MattKai45/Tach-to-CAN/Tach-to-CAN.brd

## EAGLE design Tach-to-CAN.brd (2020-04-09)

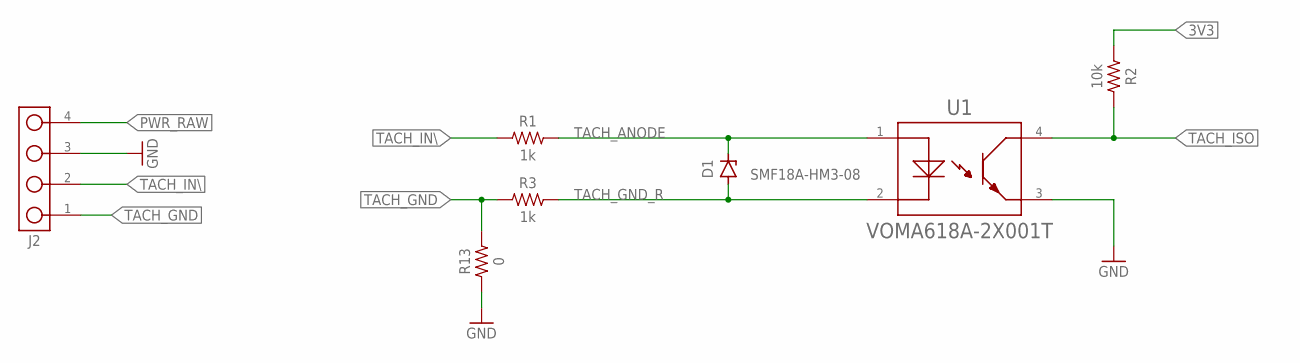
[picture p1: schematic Tach-to-CAN.sch, sheet 1, TACHOMETER ISOLATION]

Parts:
D1: VISHAY_SMF18A-HM3-08; VISHAY_SMFXXA-HM3-08
J2: CONN_4PIN_VERT; CONN_100MIL_4_PIN
R1, R3: 1k; REST-0603
R2: 10k; REST-0603
R13: 0; REST-0603
U1: VISHAY_VOMA618A-2X001T; VISHAY_SOP-4

Connections:
3V3: R2.1; also elsewhere on the board
GND: J2.3, R13.1, U1.3; also elsewhere on the board
PWR_RAW: J2.4; also elsewhere on the board
TACH_ANODE: D1.C, R1.2, U1.1
TACH_GND: J2.1, R3.1, R13.2
TACH_GND_R: D1.A, R3.2, U1.2
TACH_IN\: J2.2, R1.1
TACH_ISO: R2.2, U1.4; also elsewhere on the board

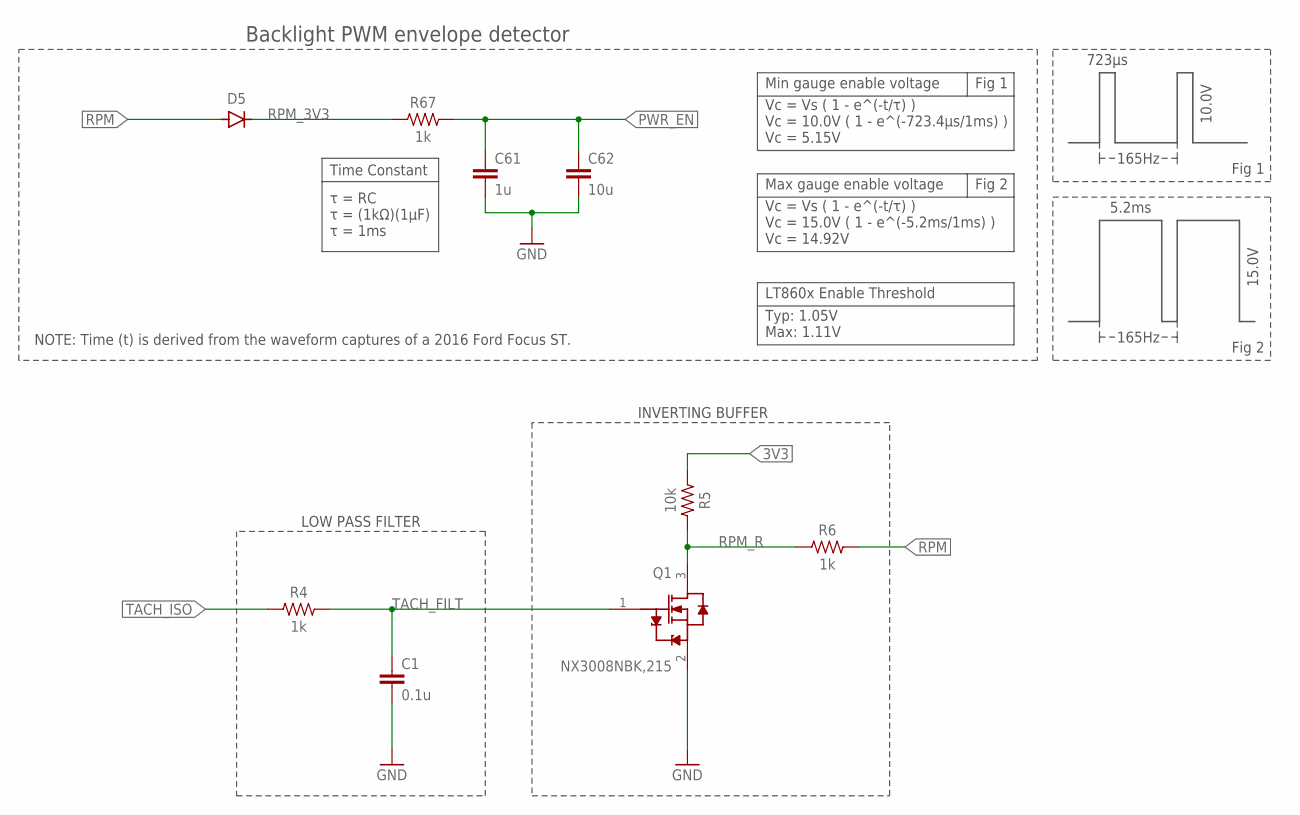
[picture p2: schematic Tach-to-CAN.sch, sheet 2, SIGNAL CONDITIONING]

Parts:
C1: 0.1u; CAP-0603
C61: 1u; CAP-0805
C62: 10u; CAP-1206
D5: AVX_SD1206S040S2R0
Q1: NXP_NX3008NBK,215NXP_SOT23; NXP_SOT23
R4, R6, R67: 1k; REST-0603
R5: 10k; REST-0603

Connections:
3V3: R5.1; also elsewhere on the board
GND: C1.2, C61.2, C62.2, Q1.2 (S); also elsewhere on the board
PWR_EN: C61.1, C62.1, R67.2; also elsewhere on the board
RPM: D5.A, R6.2; also elsewhere on the board
RPM_3V3: D5.C, R67.1
RPM_R: Q1.3 (D), R5.2, R6.1
TACH_FILT: C1.1, Q1.1 (G), R4.2
TACH_ISO: R4.1; also elsewhere on the board

Notes on the sheet:
LOW PASS FILTER
INVERTING BUFFER
Backlight PWM envelope detector
τ = RC τ = (1kΩ)(1µF) τ = 1ms
Vc = Vs ( 1 - e^(-t/τ) ) Vc = 10.0V ( 1 - e^(-723.4µs/1ms) ) Vc = 5.15V
Vc = Vs ( 1 - e^(-t/τ) ) Vc = 15.0V ( 1 - e^(-5.2ms/1ms) ) Vc = 14.92V
Max gauge enable voltage
Min gauge enable voltage
Time Constant
Typ: 1.05V Max: 1.11V
LT860x Enable Threshold
NOTE: Time (t) is derived from the waveform captures of a 2016 Ford Focus ST.
723µs
5.2ms
15.0V
10.0V
165Hz
Fig 1
Fig 2

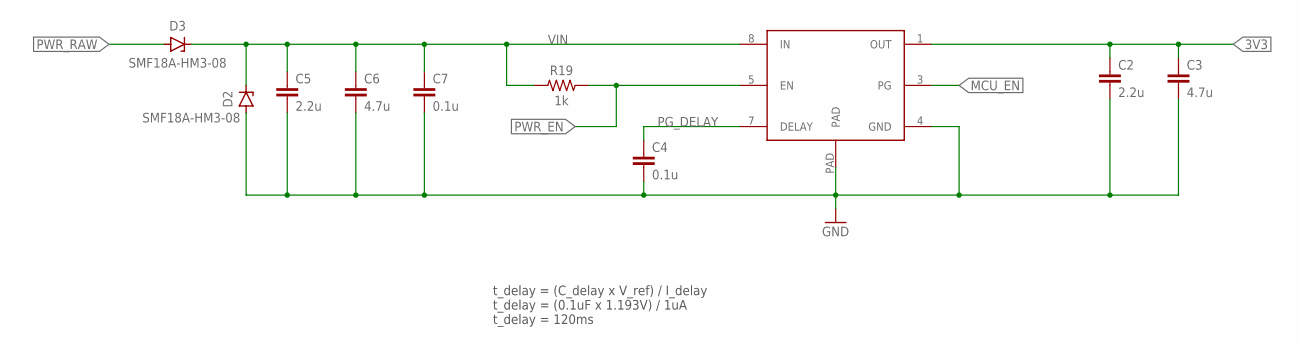
[picture p3: schematic Tach-to-CAN.sch, sheet 3, POWER]

Parts:
C2, C5: 2.2u; CAP-0805
C3, C6: 4.7u; CAP-1206
C4, C7: 0.1u; CAP-0603
D2, D3: VISHAY_SMF18A-HM3-08; VISHAY_SMFXXA-HM3-08
R19: 1k; REST-0603
U3: TI_TPS7A1633AQDGNRQ1; TI_MSSOP8

Connections:
3V3: C2.1, C3.1, U3.1 (OUT); also elsewhere on the board
GND: C2.2, C3.2, C4.2, C5.2, C6.2, C7.2, D2.A, U3.4 (GND), U3.PAD; also elsewhere on the board
MCU_EN: U3.3 (PG); also elsewhere on the board
PG_DELAY: C4.1, U3.7 (DELAY)
PWR_EN: R19.2, U3.5 (EN); also elsewhere on the board
PWR_RAW: D3.A; also elsewhere on the board
VIN: C5.1, C6.1, C7.1, D2.C, D3.C, R19.1, U3.8 (IN)

Notes on the sheet:
t_delay = (C_delay x V_ref) / I_delay t_delay = (0.1uF x 1.193V) / 1uA t_delay = 120ms

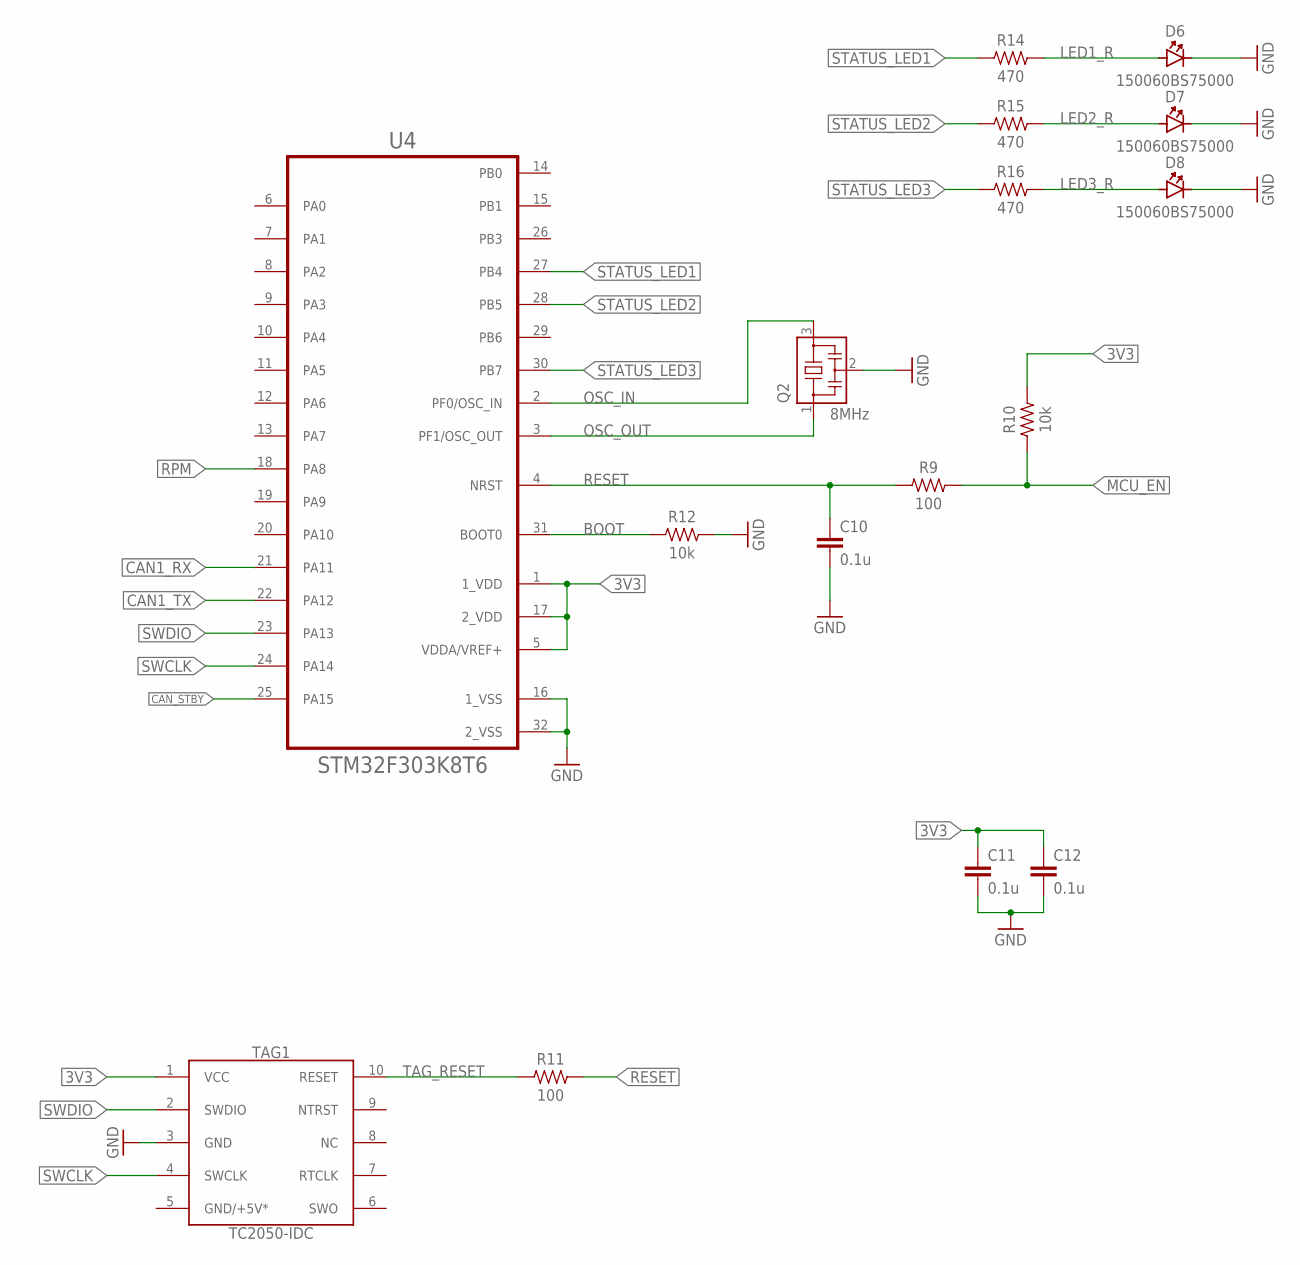
[picture p4: schematic Tach-to-CAN.sch, sheet 4, MICROCONTROLLER]

Parts:
C10, C11, C12: 0.1u; CAP-0603
D6, D7, D8: LED_BLUE_0603_WURTH; WURTH_0603_LED
Q2: 8MHz; CSTCR6M
R9, R11: 100; REST-0603
R10, R12: 10k; REST-0603
R14, R15, R16: 470; REST-0603
TAG1: TC2050-IDC
U4: STM32F303K8T6STMICROELECTRONICS_STM32F303K8T6; STM32F303K8T6

Connections:
3V3: C11.1, C12.1, R10.2, TAG1.1 (VCC), U4.1 (1_VDD), U4.5 (VDDA/VREF+), U4.17 (2_VDD); also elsewhere on the board
BOOT: R12.1, U4.31 (BOOT0)
CAN1_RX: U4.21 (PA11); also elsewhere on the board
CAN1_TX: U4.22 (PA12); also elsewhere on the board
CAN_STBY: U4.25 (PA15); also elsewhere on the board
GND: C10.2, C11.2, C12.2, D6.C, D7.C, D8.C, Q2.2, R12.2, TAG1.3 (GND), U4.16 (1_VSS), U4.32 (2_VSS); also elsewhere on the board
LED1_R: D6.A, R14.2
LED2_R: D7.A, R15.2
LED3_R: D8.A, R16.2
MCU_EN: R9.2, R10.1; also elsewhere on the board
OSC_IN: Q2.3, U4.2 (PF0/OSC_IN)
OSC_OUT: Q2.1, U4.3 (PF1/OSC_OUT)
RESET: C10.1, R9.1, R11.2, U4.4 (NRST)
RPM: U4.18 (PA8); also elsewhere on the board
STATUS_LED1: R14.1, U4.27 (PB4)
STATUS_LED2: R15.1, U4.28 (PB5)
STATUS_LED3: R16.1, U4.30 (PB7)
SWCLK: TAG1.4 (SWCLK), U4.24 (PA14)
SWDIO: TAG1.2 (SWDIO), U4.23 (PA13)
TAG_RESET: R11.1, TAG1.10 (RESET)

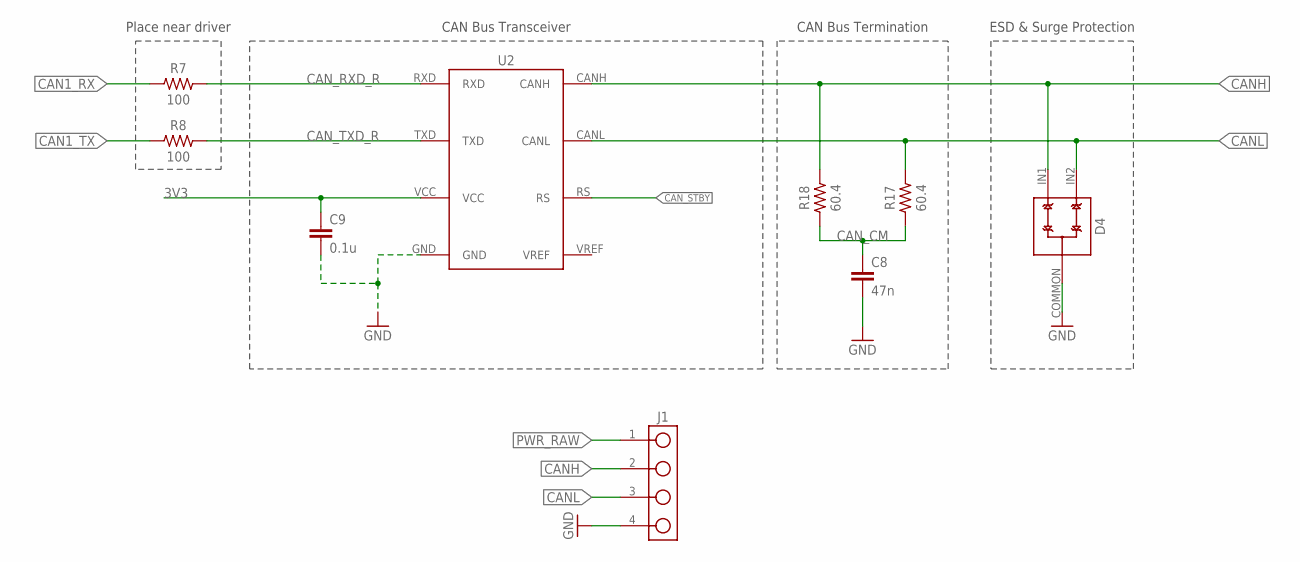
[picture p5: schematic Tach-to-CAN.sch, sheet 5, CAN BUS]

Parts:
C8: 47n; CAP-0603
C9: 0.1u; CAP-0603
D4: CDSOT23-T24CAN-Q; BOURNS_CDSOT23-T24CAN-Q
J1: CONN_4PIN_VERT; CONN_100MIL_4_PIN
R7, R8: 100; REST-0603
R17, R18: 60.4; REST-0603
U2: TI_SN65HVD23X

Connections:
3V3: C9.1, U2.VCC; also elsewhere on the board
CAN1_RX: R7.1; also elsewhere on the board
CAN1_TX: R8.1; also elsewhere on the board
CANH: D4.IN1 (IN2), J1.2, R18.2, U2.CANH
CANL: D4.IN2 (IN1), J1.3, R17.2, U2.CANL
CAN_CM: C8.1, R17.1, R18.1
CAN_RXD_R: R7.2, U2.RXD
CAN_STBY: U2.RS; also elsewhere on the board
CAN_TXD_R: R8.2, U2.TXD
GND: C8.2, C9.2, D4.COMMON (OUT), J1.4, U2.GND; also elsewhere on the board
PWR_RAW: J1.1; also elsewhere on the board

Notes on the sheet:
ESD & Surge Protection
CAN Bus Termination
CAN Bus Transceiver
Place near driver

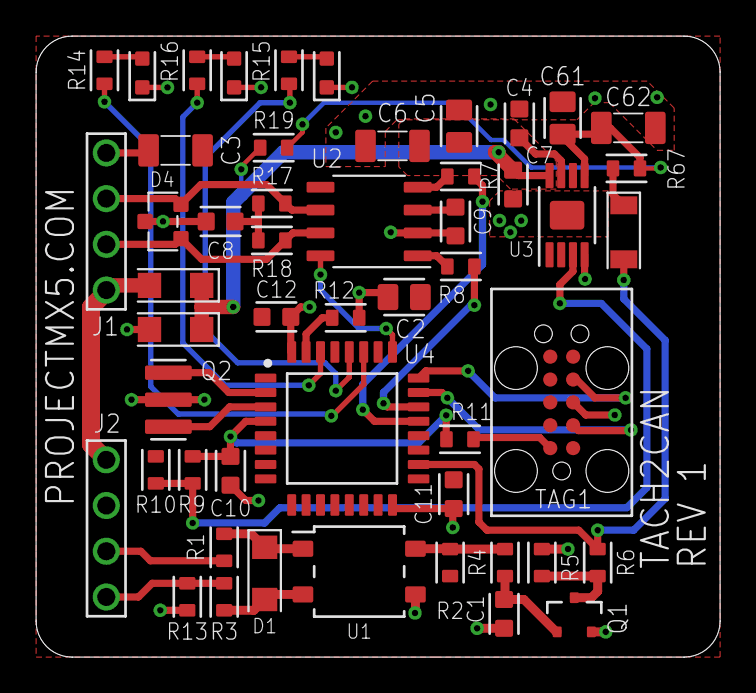
[picture p6: board Tach-to-CAN.brd from above]

Board: 2 copper layers, 38.0 x 34.5 mm, 51 parts (0 on the bottom side), 37 nets.
