MattKai45/Tach-to-CAN/firmware/Core/Src/main.c

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

/* Includes ------------------------------------------------------------------*/
#include "main.h"
#include "can.h"
#include "tim.h"
#include "gpio.h"

/* USER CODE BEGIN Includes */

#include "stdio.h"

/* USER CODE END Includes */

/* USER CODE BEGIN PTD */

#define RPM_TIM &htim1
#define RPM_TIM_UNITS 1000 /* milliseconds */

#define NUMBER_OF_CYLINDERS 4
#define ENGINE_CYL_FACTOR (NUMBER_OF_CYLINDERS / 2)
#define RPS2RPM 60 /* Rotations per second to Rotations per minute */

#define TIM_CALIBRATION 15

/* Set the arbitration ID here */
#define ENGINE_RPM_ARB_ID    0x090

/* USER CODE END PTD */


/* USER CODE BEGIN PV */

uint32_t pulse_t = 0;

uint32_t engine_rpm = 0;

CAN_TxHeaderTypeDef Header = {
        .DLC                = 8,
        .ExtId              = ENGINE_RPM_ARB_ID,
        .StdId              = ENGINE_RPM_ARB_ID,
        .IDE                = CAN_ID_STD,
        .RTR                = CAN_RTR_DATA,
        .TransmitGlobalTime = DISABLE
};

uint32_t blink = 0;
#define NORMAL_OPERATION 750
#define ERROR_MODE       100
uint32_t blink_rate = NORMAL_OPERATION;

/* USER CODE END PV */

void SystemClock_Config(void);
/* USER CODE BEGIN 0 */

HAL_StatusTypeDef can_filter( CAN_HandleTypeDef *pcan, uint32_t id, uint32_t mask, uint32_t format, uint32_t filterBank, uint32_t FIFO  )
{
    if ( (format == CAN_ID_STD) || (format == CAN_ID_EXT) )
    {
        /** Declare a CAN filter configuration */
        CAN_FilterTypeDef  sFilterConfig;

        /** Verify the filter bank is possible */
        if ( (filterBank >= 0) && (filterBank <= 13) )
            sFilterConfig.FilterBank = filterBank;
        else
            return -1;

        sFilterConfig.FilterMode = CAN_FILTERMODE_IDMASK;
        sFilterConfig.FilterScale = CAN_FILTERSCALE_32BIT;

        if (format == CAN_ID_STD) {
            sFilterConfig.FilterIdHigh = ((id << 5) | (id >> (32 - 5))) & 0xFFFF;
            sFilterConfig.FilterIdLow =  (id >> (11-3)) & 0xFFF8;
            sFilterConfig.FilterMaskIdHigh = ((mask << 5) | (mask >> (32-5))) & 0xFFFF;
            sFilterConfig.FilterMaskIdLow = (mask >> (11-3)) & 0xFFF8;
        } else { // format == CANExtended
            sFilterConfig.FilterIdHigh = id >> 13; // EXTID[28:13]
            sFilterConfig.FilterIdLow = (0xFFFF & (id << 3)) | (1 << 2); // EXTID[12:0] + IDE
            sFilterConfig.FilterMaskIdHigh = mask >> 13;
            sFilterConfig.FilterMaskIdLow = (0xFFFF & (mask << 3)) | (1 << 2);
        }

        sFilterConfig.FilterFIFOAssignment = FIFO;
        sFilterConfig.FilterActivation = ENABLE;
        sFilterConfig.FilterBank = filterBank;
        sFilterConfig.SlaveStartFilterBank = 0x12;

        return HAL_CAN_ConfigFilter(pcan, &sFilterConfig);
    }
    return HAL_ERROR;
}

static uint8_t Engine_RPM_Tx_CAN_Bus()
{
    uint32_t pTxMailbox = 0;

    uint8_t tx_buf[8];

    /* Create your custom payload here */
    tx_buf[0] = 0x03;
    tx_buf[1] = 0x41;
    tx_buf[2] = 0x0C;
    tx_buf[3] = 0x12;
    tx_buf[4] = (uint8_t)(((engine_rpm) >> 8) & 0xFF);
    tx_buf[5] = (uint8_t)((engine_rpm) & 0xFF);
    tx_buf[6] = 0xff;
    tx_buf[7] = 0xff;

    if( HAL_CAN_AddTxMessage( &hcan, &Header, tx_buf, &pTxMailbox ) == HAL_OK )
        return 1;
    else
        return 0;
}

/* USER CODE END 0 */

/**
  * @brief  The application entry point.
  * @retval int
  */
int main(void)
{
  /* MCU Configuration--------------------------------------------------------*/

  /* Reset of all peripherals, Initializes the Flash interface and the Systick. */
  HAL_Init();

  /* Configure the system clock */
  SystemClock_Config();

  /* Initialize all configured peripherals */
  MX_GPIO_Init();
  MX_TIM1_Init();
  MX_TIM16_Init();
  MX_CAN_Init();
  /* USER CODE BEGIN 2 */

  HAL_TIM_IC_Start_IT( RPM_TIM,  TIM_CHANNEL_1 );

  if( can_filter( &hcan, 0x090, 0x7FF, CAN_ID_STD, 0, CAN_FILTER_FIFO0 ) != HAL_OK )
      Error_Handler();

  if( HAL_CAN_Start( &hcan ) != HAL_OK )
      Error_Handler();

  /* USER CODE END 2 */

  /* Infinite loop */
  /* USER CODE BEGIN WHILE */
  while (1)
  {

      if( HAL_GetTick() > blink )
      {
          blink = HAL_GetTick() + blink_rate;
          HAL_GPIO_TogglePin(LED1_GPIO_Port, LED1_Pin);
      }
      //Engine_RPM_Tx_CAN_Bus();
      //HAL_Delay(100);
    /* USER CODE END WHILE */

    /* USER CODE BEGIN 3 */
  }
  /* USER CODE END 3 */
}

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
/* USER CODE BEGIN 4 */

char msg[64];
uint32_t len = 0;

void HAL_TIM_IC_CaptureCallback( TIM_HandleTypeDef *htim )
{
    if ( htim == RPM_TIM )
    {
        /* Clear count */
        __HAL_TIM_SET_COUNTER(htim, 0);

        pulse_t = HAL_TIM_ReadCapturedValue(htim, TIM_CHANNEL_1) + TIM_CALIBRATION;
        if( pulse_t > 0 )
        {
           engine_rpm = 30000000 / pulse_t;
           Engine_RPM_Tx_CAN_Bus();
        }
    }
}

/* USER CODE END 4 */
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
