MattKai45/Tach-to-CAN/firmware/mazda_miata_tach_to_can.ioc

Mcu.UserName=STM32F303K8Tx
PA11.Signal=CAN_RX
PA12.Signal=CAN_TX
PA13.GPIO_Label=SWDIO
PA13.Signal=SYS_JTMS-SWDIO
PA14.GPIO_Label=SWCLK
PA14.Signal=SYS_JTCK-SWCLK
PA15.GPIO_Label=CAN_STBY
PA15.Signal=GPIO_Output
PA2.GPIO_Label=VCP_TX
PA2.Signal=USART2_TX
PA8.Signal=S_TIM1_CH1
PB4.GPIO_Label=LED1
PB4.Signal=GPIO_Output
PB5.GPIO_Label=LED2
PB5.Signal=GPIO_Output
PB7.GPIO_Label=LED3
PB7.Signal=GPIO_Output
