MattKai45/Tach-to-CAN/firmware/Core/Inc/main.h

#define VCP_TX_Pin GPIO_PIN_2
#define VCP_TX_GPIO_Port GPIOA
#define SWDIO_Pin GPIO_PIN_13
#define SWDIO_GPIO_Port GPIOA
#define SWCLK_Pin GPIO_PIN_14
#define SWCLK_GPIO_Port GPIOA
#define CAN_STBY_Pin GPIO_PIN_15
#define CAN_STBY_GPIO_Port GPIOA
#define LED1_Pin GPIO_PIN_4
#define LED1_GPIO_Port GPIOB
#define LED2_Pin GPIO_PIN_5
#define LED2_GPIO_Port GPIOB
#define LED3_Pin GPIO_PIN_7
#define LED3_GPIO_Port GPIOB
