MattKai45/Tach-to-CAN/(commit log)

2020-04-09 Board and Schematic initial commit
    [Tach-to-CAN.brd, Tach-to-CAN.sch]
2022-01-21 Update device to use internal clock
2022-01-21 Calibrate frequency measurements
2022-01-21 Return 1:1 Engine RPM values on the CAN bus
2022-01-22 Indicate an error occurred when the Error_Handler is called
    [main.c]
